ffareedabbasi47-hub/Transformer-/ESP32/README.md

# STSMN ESP32 firmware (v1.1)

Low-voltage **educational demonstration** only. Never connect it to 230 V mains or a real distribution transformer.
Not certified protection equipment. A qualified adult/technician must review any real installation.

## Files
| Path | What |
|---|---|
| `stsmn_firmware/` | Canonical Arduino sketch folder: `stsmn_firmware.ino` + `config.h`, `util.h`, `risk_engine.h`, `protection_logic.h`, `sensors.h`, `actuators.h`, `secrets.h.example` |
| `stsmn_single/stsmn_single.ino` | The same firmware in ONE file for copy-paste (generated by `python3 tools/make_single_ino.py`) |

## Build (Arduino IDE 2.x)
1. Install **ESP32 by Espressif Systems** (core 2.x or 3.x) in Boards Manager.
2. Library Manager: **OneWire**, **DallasTemperature**.
3. Board: **ESP32 Dev Module** (ESP32 DevKit V1 / WROOM-32). Upload speed 921600 or 115200. Serial Monitor 115200.
4. Multi-file: copy `secrets.h.example` to `secrets.h` in the sketch folder and set a **new** password (8-63 characters).
   The sketch refuses to compile with the public example password. Single-file: edit `WIFI_AP_PASSWORD` near the top.
5. Upload. Phone joins Wi-Fi `STSMN-TR001`, app uses `192.168.4.1`.

## Pin map (all in `config.h`; ADC1 only because ADC2 is unusable with Wi-Fi)
| GPIO | Function | Note |
|---|---|---|
| 4 | DS18B20 data | 4.7 k pull-up to 3.3 V |
| 34 | ACS712 out | through 10 k / 20 k divider (sensor is 5 V) |
| 35 | Voltage module | keep input <= 15 V |
| 32 | MQ-2 AO | through 10 k / 20 k divider |
| 33 | Water-level sensor | powered from 3.3 V (demo: water only) |
| 25 | Flame DO | internal pull-up (active-low module) |
| 26 | Relay IN | `RELAY_ACTIVE_LOW` in config.h, verify on your module |
| 18 / 19 / 23 | LED green / yellow / red | |
| 27 | Active buzzer | |
| 16 / 17 | GPS NEO-6M: ESP32 RX <- GPS TXD / ESP32 TX -> GPS RXD | UART2, 9600 baud |
| 13 / 14 | SIM800L: ESP32 RX <- SIM TXD / ESP32 TX -> SIM RXD | UART1, 9600 baud; 1k+2k divider on 14; SIM800L powered from its own 3.7-4.2 V supply, common GND |

## GPS and SMS (new in this version)
* `gps_nmea.h` reads the NEO-6M (only checksum-valid RMC/GGA sentences). A position is reported only while the module has a real fix; no fix for 10 s = `null`, never an old or invented position.
* `sim800.h` + `sms_logic.h`: when the status ENTERS EMERGENCY, one SMS goes to `ALERT_PHONE_NUMBER` (set it in `secrets.h`; the `+91XXXXXXXXXX` placeholder keeps SMS off): `STSMN TR-001 EMERGENCY risk 92/100 temp 71.2C https://maps.google.com/?q=LAT,LNG` (or `GPS: no fix`). At most one per 2 min, reminder every 30 min while the alarm lasts, failed sends are retried. Warning SMS: `SMS_ON_WARNING` in config.h.
* GPS and SIM run in their own low-priority task; they never touch the relay, sensors or the protection task.
* `GET /api/health` additionally returns `gpsFix, gpsSats, lat, lng, gsmReady, gsmRegistered, gsmSignal, smsEnabled, smsSent, smsFailed` (`lat/lng` are `null` without a fix). `/api/status` is unchanged.
* SIM800L is a 2G modem: it needs a 2G network in your area. Beginner wiring guide: `docs/STSMN_Wiring_Guide.pdf`.

## Behaviour that matters
* Protection (sensors, risk score, relay, LEDs, buzzer) runs in its **own FreeRTOS task** (priority 3, core 1) with a task watchdog (8 s). The HTTP server runs in the Arduino loop; a slow/stalled client cannot delay protection. The phone can never arm, disarm or override anything.
* **Relay stays cut at boot** and is only allowed after the 3 s boot check AND all protection sensors (temperature, current, voltage) have been valid for 2 s. EMERGENCY cuts it; a sensor fault lasting 10 s cuts it; both need a fresh stable-valid period to come back.
* Invalid sensors are reported as `null` in JSON, never as 0.
* If the firmware hangs, the watchdog resets the ESP32; the relay pin is then high-impedance until `setup()` runs, so **wire the load through COM + NO** and use a module whose input idles to "off".

## API (read-only, plain HTTP on the WPA2 access point)
`GET /api/status` -> `deviceId, fw, uptime (ms, 64-bit), temperature, voltage, current, smoke, flame, oilLevel, risk, status, relay, alarm, seq`
(`temperature/voltage/current/oilLevel` are numbers or `null` when invalid).
`GET /api/health` -> `deviceId, fw, uptime, seq, clients, mq2Ready, tempValid, currentValid, voltageValid, relayMismatch, armed, heapFree, stackFreeBytes`.
Errors: `404 {"error":"not found"}`, `405` + `Allow: GET` for other methods on these paths, `503` before the first state exists.

## Calibration checklist (values in `config.h` are DEMO assumptions, not verified on your modules)
- [ ] ACS712: idle level at the ADC pin must be 1.2-2.1 V; check `ACS_MV_PER_A` for your variant (5/20/30 A) and the divider ratio.
- [ ] Voltage module: compare with a multimeter, set `VOLT_CAL_FACTOR`; set `NOMINAL_VOLTAGE_V` for your supply.
- [ ] MQ-2: needs 24-48 h burn-in the first time; baseline is taken after 60 s in clean air (smoke present at that moment = wrong baseline).
- [ ] Water level: set `LEVEL_DRY_MV` / `LEVEL_FULL_MV` with the sensor dry and fully wet.
- [ ] Relay polarity (`RELAY_ACTIVE_LOW`) and flame polarity (`FLAME_ACTIVE_LOW`) on your modules.
- [ ] Thresholds (`TEMP_*`, `CURRENT_*`, risk limits) are demo values.

## Tests (no hardware)
```
cd tests
g++ -std=c++17 -I../ESP32/stsmn_firmware risk_engine_test.cpp -o risk_test && ./risk_test
g++ -std=c++17 -I../ESP32/stsmn_firmware gps_sms_test.cpp -o gps_sms_test && ./gps_sms_test
g++ -std=c++17 -I../ESP32/stsmn_firmware protection_logic_test.cpp -o prot_test && ./prot_test
g++ -std=c++17 -Ifirmware/mock -I../ESP32/stsmn_firmware firmware/sensor_actuator_test.cpp -o sensor_test && ./sensor_test
cd .. && sh tests/firmware/compile_sketch.sh        # syntax check against HOST MOCKS, not the ESP32 core
```

## Sensors you have not wired (config.h `HAS_*`)
A sensor that is not connected has a floating pin and reads random numbers. Set `HAS_TEMP_SENSOR`, `HAS_CURRENT_SENSOR`,
`HAS_VOLTAGE_SENSOR` or `HAS_LEVEL_SENSOR` to `false` for anything you did not fit: it is reported as `null` (the app shows "-"),
adds no risk points and is not a sensor fault, so it can no longer hold the status at WARNING (risk 45) or keep the relay from arming.
The Serial log prints `ok(T I V)` for the sensors that are really valid, `mq=<now>/<baseline>` for the smoke sensor, and `/api/health`
carries `mq2Mv` / `mq2BaseMv`.

## Smoke
MQ-2 smoke now raises the status to at least WARNING at once, and EMERGENCY (supply cut) if it lasts `CRIT_SMOKE_HOLD_MS` (3 s),
with or without heat. The clean-air baseline follows slow drift; the trigger is `MQ2_DELTA_ENTER_MV` (120 mV) above it.

## Relay does not switch off?
5V relay modules driven from the ESP32's 3.3V often stay ON when the pin is set HIGH ("cut"). `RELAY_OPEN_DRAIN_OFF = true` (config.h) fixes that:
cut = pin released (the module's own pull-up turns the relay OFF), on = pin driven LOW. Check by hand: at boot the relay module's LED is OFF;
~5 s later (all fitted sensors valid) it turns ON; in EMERGENCY it turns OFF again. Wire the load to COM + NO. If your module is active-HIGH, set `RELAY_ACTIVE_LOW = false`.

## Auto-detect of unplugged sensors, restarts (v1.1.x)
- `AUTO_IGNORE_UNPLUGGED=true` (config.h): a temperature / current / voltage sensor that has never given a valid reading since boot is treated as *not connected* (ignored, `null` in the app) - no 45 % floor, no yellow light, relay is allowed. If a sensor worked and then fails, that IS a fault (WARNING, supply cut after 10 s).
- Repeated restarts are almost always a **power dip** (BROWNOUT): a phone OTG port cannot power ESP32 + Wi-Fi + relay + MQ-2 heater. Use a power bank / 5V 2A supply. `/api/health` shows `resetReason` and the Serial Monitor prints it at boot. Wi-Fi TX power is lowered to reduce current peaks; protection task stack raised to 10 KB.

## Bluetooth (BLE) monitoring
`ENABLE_BLE` in config.h (default **0**). Set it to 1 and choose **Partition Scheme "Huge APP (3MB No OTA/1MB SPIFFS)"** in the board options (the BLE stack makes the sketch ~1.6 MB; the default partition is 1.3 MB, otherwise "Sketch too big"). The ESP32 advertises as `STSMN-TR001` (Nordic UART service); the app (Settings > Link > Bluetooth) or any BLE terminal app shows lines `ST {status json}` every 1 s and `HE {health json}` every 5 s. The only write is `PHONE <device password> <number>` (saves the SMS number; the password is WIFI_AP_PASSWORD, no spaces). Monitoring over BLE is open to anyone in range (same data the Wi-Fi API serves); relay and thresholds cannot be reached. Wi-Fi AP keeps working in parallel.
