ffareedabbasi47-hub/Transformer-/docs/wiring/STSMN_wiring_diagram.png

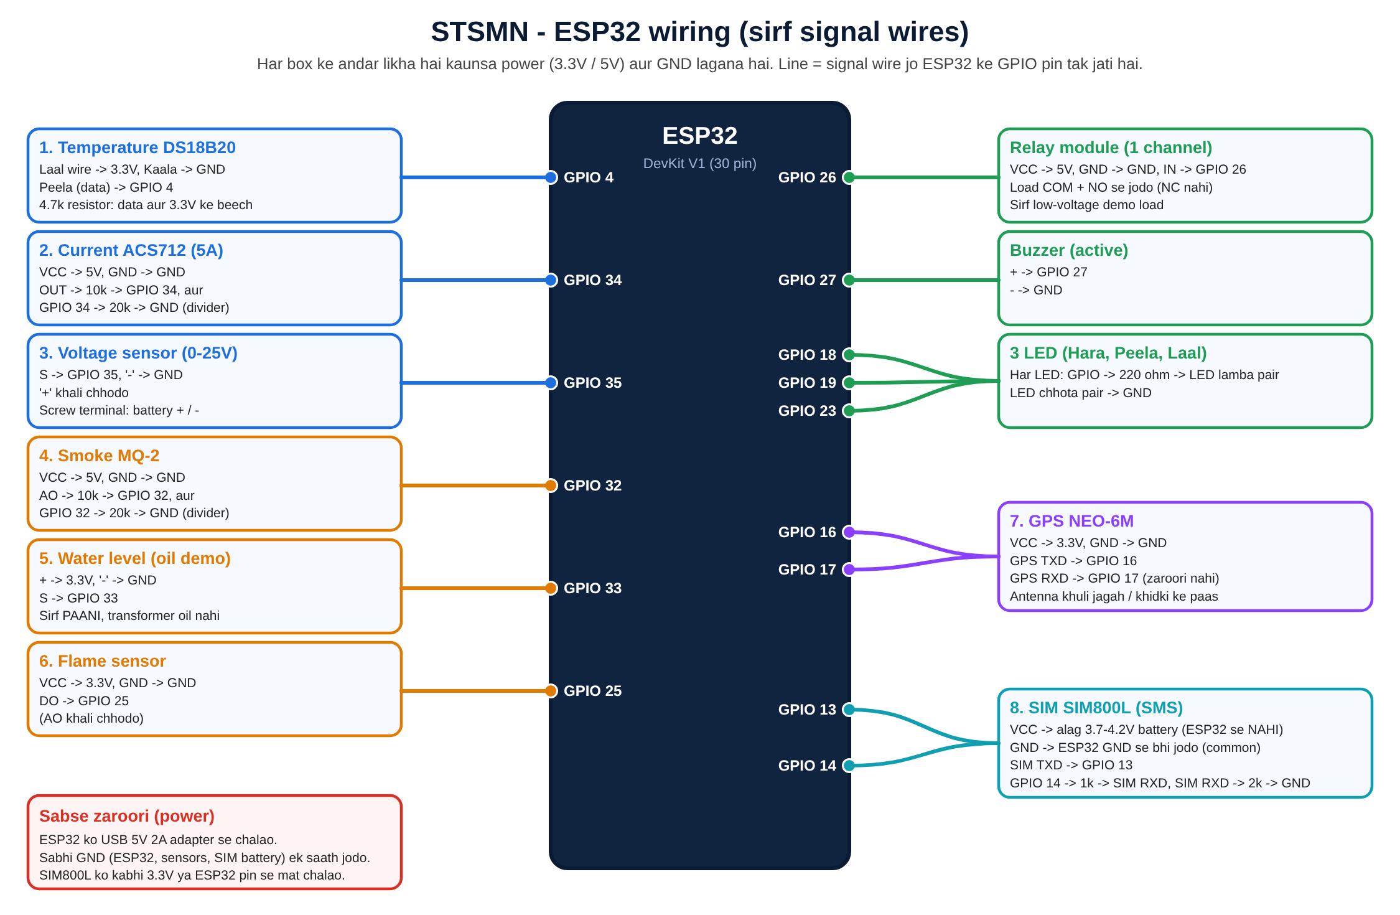
docs/wiring/STSMN_wiring_diagram.png
