ffareedabbasi47-hub/Transformer-/(commit log)

2026-10-10 Security: pin ws 8.21.3 (fixes 2 high advisories)
2026-11-05 Globe: switch tile provider after 5s without tiles, show reason on screen
    Claude-Session: https://claude.ai/code/session_015czFbUr983AJUZrhSXmn7q
2026-11-05 Map: ocean base layer, blank-render probe, diagnostics line, auto-switch to offline globe when satellite view cannot show anything
    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
2026-11-05 Map: native satellite map (osmdroid + Esri imagery), 3D page must prove it paints or app switches to it and remembers
    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
2026-11-05 ESP32: single-file sketch (copy-paste friendly) in ESP32/stsmn_single
    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
2026-11-05 Map: native satellite map is the default, 3D Earth opt-in via left-edge button; keep WebGL buffer, calmer provider timeout
    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
2026-11-05 tests: longer wait for provider fallback chain
    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
2026-11-06 ESP32 firmware v1.1: protection task + watchdog, relay arming gate, boot-pulse/flame/smoke/stale-average fixes, host tests, docs; 3D page layout diagnostics
    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
    [actuators.h, config.h]
2026-11-06 feat: GPU (OpenGL ES) 3D Earth - smooth drag with momentum, glued markers, animated zoom/India, seamless dive into map
    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
2026-11-06 feat(map): fly-to-site on globe, double-tap zoom, TR-xxx labels, labelled List/Globe buttons
    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
2026-11-06 feat(map): layers (satellite/terrain/streets + roads), search, status filters, clustering, map-to-globe flight, full screen, transformer sheet
    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
2026-11-06 docs: map sprint test report (honest: no device testing)
    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
2026-11-06 feat(ui): premium visual pass - deep-space theme and type scale, flat surfaces, compact markers, globe lighting/atmosphere, eased cinematic camera, animated panels
    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
2026-11-06 feat(esp32): GPS (NEO-6M) + SIM800L SMS alerts, host tests, beginner wiring guide (PDF + diagram)
    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
2026-11-07 fix(esp32): single-file sketch failed under the Arduino IDE's automatic prototypes (types used before definition); add forward declarations + CI simulation
    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
    [arduino_proto_check.py, make_single_ino.py, stsmn_single.ino]
2026-11-07 ci(esp32): compile the sketch with the real ESP32 Arduino core (3.3.5 and 2.0.17)
    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
2026-11-07 fix(esp32): editor-friendly sketch (no default args in helpers, no libc strtod)
    ArduinoDroid's analyzer flagged redefinition of default argument, static_assert not constant and strtod. Helpers now take explicit args; GPS coordinate parser is self-contained.
    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
    [gps_nmea.h, stsmn_firmware.ino, stsmn_single.ino]
2026-11-07 feat(app): show the ESP32's live GPS position (from /api/health) on the map
    The app never read the GPS fix, so the map always showed the configured/demo site. It now asks /api/health every 5 s
    (read-only, failures ignored), uses the fix only when gpsFix=true and the coordinate is real, falls back to the configured
    location after 60 s without a fix, and labels it LIVE GPS.
    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
2026-11-07 fix(esp32): unfitted sensors are not faults, smoke is detected and acted on, clearer diagnostics
    - HAS_* flags: an unwired sensor is reported null, scores nothing and no longer forces risk 45 / WARNING or blocks relay arming.
    - Smoke: adaptive baseline, lower trigger (120 mV), smoke alone = WARNING at once and EMERGENCY (relay cut) after 3 s.
    - Serial + /api/health show which sensors are valid and the MQ-2 reading.
    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
    [config.h, risk_engine.h, sensors.h, stsmn_firmware.ino, stsmn_single.ino]
2026-11-07 feat(esp32): fire/smoke 50-50 scoring with signal strength, floors, alert phone number saved on the device
    - smoke 50 pts, fire 50 (flame 35 + temperature 15); graded by signal strength; optional flame AO.
    - smoke + fire together = EMERGENCY at once; stress floor for temp/current/voltage.
    - /api/status gets a pct object (strength per sensor); POST /api/contact stores the SMS number in NVS; /api/health shows it masked.
    - docs/RISK_ALGORITHM.md.
    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
2026-11-07 feat(app): alert number (SMS + WhatsApp), signal-strength card, number synced to the ESP32
    - Settings > Alert number: saved in the app and sent to the ESP32 (POST /api/contact, re-synced automatically); SMS goes to it.
    - WhatsApp: one-tap button on the dashboard + notification action; optional fully automatic send with the person's own CallMeBot key.
    - Dashboard shows per-sensor signal strength (fire, smoke, temperature, current, voltage) with weak/medium/strong.
    - Parsers for the optional pct block and the masked number; unit tests.
    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
2026-11-07 fix: relay cut works with 3.3V-driven relay modules; signal strength moved to Sensor Data; WhatsApp is automatic only (no buttons)
    - Relay: open-drain cut for active-low modules (a 3.3V HIGH did not release many 5V modules).
    - App: signal-strength card now sits under the oil-level card in Sensor Data (removed from the dashboard); smoke/flame cards show percent.
    - WhatsApp: removed all buttons/notification action; automatic send with retry and an automatic confirmation message after saving the key.
    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
    [actuators.h, config.h, sensor_actuator_test.cpp, stsmn_single.ino]
2026-11-07 App: smoke/flame % trend charts in Sensor Data; add sensor plan doc
    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
2026-11-07 Fix: rename OPEN_DRAIN (clashes with ESP32 core macro) in actuators; mock defines it to catch this
    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
    [actuators.h, stsmn_single.ino]
2026-11-07 Firmware: auto-ignore never-connected sensors, reset reason, lower Wi-Fi TX power, bigger protection stack
    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
    [config.h, risk_engine.h, sensors.h, stsmn_firmware.ino, stsmn_single.ino]
2026-11-07 Firmware: yellow only from score 55, dry level sensor = 18 points, LED self-test at boot
    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
2026-11-09 Flame: AO-primary detector (baseline, flicker, sudden-rise, DO support, polarity/fail-safe), 100 Hz sampling, tests, calibration guide
    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
    [config.h, flame_detect.h, flame_detect_test.cpp, make_sensor_plan.py, make_single_ino.py, sensors.h, stsmn_firmware.ino, stsmn_single.ino]
2026-11-09 Fix crash: /api/contact response had a %s without argument (reboot when the app saved the alert number); host build now fails on format errors
    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
    [stsmn_firmware.ino, stsmn_single.ino]
2026-11-09 ESP32: BLE monitoring link (Nordic UART service): status/health notify, PHONE command with device password; shared applyContact
    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
2026-11-10 BLE default OFF (sketch too big for default partition); CI builds BLE off (default partition) and on (huge_app) on both cores
    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
    [config.h, stsmn_single.ino]
2026-11-10 Fix BLE line assembler: drop a runaway line completely
    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
2026-11-10 Flame: ratio-based thresholds, weak flame with DO/flicker detected, DO-only fallback = emergency; revert LED test, TX power and 1 ms loop; comment-free release sketch + CI
    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
    [config.h, flame_detect.h, flame_detect_test.cpp, make_release_ino.py, stsmn_firmware.ino, stsmn_single.ino]
2026-11-10 Live flame tuning: /api/flame on ESP32 (NVS) + sliders in app Settings
    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
2026-11-11 Flame: latch stays while burning, flicker scaled to signal, noise tracked under sun; fuzz test; readable slider labels
    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
    [config.h, flame_detect.h, flame_fuzz_test.cpp, stsmn_single.ino]
2026-11-11 Flame: DO-only fallback needs chatter (steady DO/sun ignored), polarity auto-flip, AO re-learn, diagnostics in app
    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
    [config.h, flame_detect.h, flame_detect_test.cpp, sensor_actuator_test.cpp, sensors.h, stsmn_firmware.ino]
2026-11-12 Safety architecture B: latched over-current lockout with authorised reset, token auth, strict validation, trip memory, boot hold, event log, oil-low state, app token/reset/invert
    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
2026-11-12 Fix Arduino prototype issue (FlameTuning in signature) and token define in single-file wifi block
    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
    [make_single_ino.py, stsmn_firmware.ino, stsmn_single.ino]
2026-11-12 Include stdlib/string/math explicitly (ArduinoDroid: strtof/strtol not found)
    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
2026-11-12 Voltage scoring 0-8 V safe then +20 pts per V; relay stays cut 15 s after any emergency, recovery 10 s; tests
    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
2026-11-12 Fuzz test: healthy voltage 3.7 V (new 0-8 V safe band)
    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
2026-11-12 Show the reason of WARNING/EMERGENCY (status field + dashboard) and over-current lock card with Reset on Home
    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
    [risk_engine.h, stsmn_firmware.ino, stsmn_single.ino]
2026-11-13 Relay cutoff: hold pin high via weak pull-up instead of floating input
    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
2026-11-13 App: theme-aware text colour (content colour fix), glass look for cards and nav bar, content scrolls under the nav bar (no cut-off box)
    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
2026-11-13 Liquid-glass drop navigation indicator (spring, stretch, specular highlight) and more premium glass cards
    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
2026-11-13 Realistic water-drop navigation (stretch, refraction rim, caustic, specular, lens magnify), animated aurora background, radar pulse and shimmer for the offline state
    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
2026-11-13 Glass buttons and chips app-wide, more colourful glass cards/background/tiles
    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
2026-11-13 Fake-reading rejection for voltage/level (stability gate, ADC dead-band), Oil tile corner badge, nav bar more opaque, fix build errors
    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
    [config.h, sensor_actuator_test.cpp, sensors.h, stsmn_single.ino]
2026-11-13 App: restore original theme colours (no hue mixing), onPrimary/light from palette, glass buttons min-height and spacing
    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
2026-11-13 Firmware: current thresholds for the demo load (warn 0.8 A, critical 2.0 A), voltage calibration factor 0.85; tests follow VOLT_CAL_FACTOR
    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
